amykyta3/nav-brick/README.md

# Nav-Brick

Have you ever wanted an altimeter for your car? Now you can.

This silly project implements an entirely over-engineered, GPS-compensated, pressure-based altimeter.
