amykyta3/nav-brick/hardware/BOM.ods

# | Reference | Value | Footprint | Qty | x3 | Have | Need | Buy | Digikey PN
1 | C2, C3, C4, C5, C6, C8, C9, C11, C13, C15, C16, C17, C18, C19, C20, C21, C22, C23, C53, C54 | 0.1u | Capacitor_SMD:C_0603_1608Metric | 20 | 60 | 39 | 21 | 30 | 399-C0603C104K3RAC7867CT-ND
2 | C7, C12 | 4.7u | Capacitor_SMD:C_0805_2012Metric | 2 | 6 | 19 | 0
3 | C10, C14, C50, C55 | 1u | Capacitor_SMD:C_0603_1608Metric | 4 | 12 | 71 | 0
4 | C51, C52 | 0.01u | Capacitor_SMD:C_0603_1608Metric | 2 | 6 | 74 | 0
5 | FB1 | FB | Capacitor_SMD:C_0603_1608Metric | 1 | 3 | 0 | 3 | 10 | 490-1037-1-ND
8 | J52 | USB4105-GF-A | Connector_USB:USB_C_Receptacle_GCT_USB4105-xx-A_16P_TopMnt_Horizontal | 1 | 3 | 0 | 3 | 5 | 2073-USB4105-GF-ACT-ND
14 | Q1, Q2, Q3, Q4 | DMP2004VK | 0-footprints:SOT-563 | 4 | 12 | 0 | 12 | 15 | DMP2004VKDICT-ND
15 | R2, R3, R4, R5, R6, R7, R8, R9 | 2.7k | Resistor_SMD:R_0402_1005Metric | 8 | 24 | 0 | 24 | 30 | 541-2.70KLCT-ND
16 | R50, R51 | 5.1k | Resistor_SMD:R_0402_1005Metric | 2 | 6 | 0 | 6 | 8 | 541-5.10KLCT-ND
17 | R52 | 1k | Resistor_SMD:R_0402_1005Metric | 1 | 3 | 75 | 0
18 | R53, R54 | 2.2k | Resistor_SMD:R_0402_1005Metric | 2 | 6 | 4 | 2 | 5 | 541-2.20KLCT-ND
19 | SW50, SW51 | PTS645SK50SMTR92 | Button_Switch_SMD:SW_Push_1P1T_NO_6x6mm_H9.5mm | 2 | 6 | 1 | 5 | 15 | CKN9087CT-ND
21 | U2 | MLX90393SLW-ABA-011 | Package_DFN_QFN:QFN-16-1EP_3x3mm_P0.5mm_EP1.7x1.7mm | 1 | 3 | 0 | 3 | 3 | MLX90393SLW-ABA-011-RECT-ND
22 | U3 | MM74HCT540MTCX | Package_SO:TSSOP-20_4.4x6.5mm_P0.65mm | 1 | 3 | 0 | 3 | 3 | MM74HCT540MTCXCT-ND
23 | U4 | MS5611-01BA | Package_LGA:LGA-8_3x5mm_P1.25mm | 1 | 3 | 0 | 3 | 3 | 223-1622-1-ND
24 | U5 | MM74HCT541MTCX | Package_SO:TSSOP-20_4.4x6.5mm_P0.65mm | 1 | 3 | 0 | 3 | 3 | MM74HCT541MTCXCT-ND
25 | U6 | AVR128DA32x-xRXB | Package_DFN_QFN:QFN-32-1EP_5x5mm_P0.5mm_EP3.1x3.1mm | 1 | 3 | 0 | 3 | 3 | 150-AVR128DA32T-I/RXBCT-ND
26 | U7 | FM25L16B | Package_SO:SOIC-8_3.9x4.9mm_P1.27mm | 1 | 3 | 0 | 3 | 3 | 448-FM25L16B-GTRCT-ND
27 | U8 | LP2981A-33DBV | Package_TO_SOT_SMD:SOT-23-5 | 1 | 3 | 4 | 0
28 | U9, U10, U11, U12, U13, U14, U15, U16 | TLC59284 | Package_SO:SSOP-24_3.9x8.7mm_P0.635mm | 8 | 24 | 0 | 24 | 26 | 296-39245-1-ND
29 | U50 | CY7C65223D | Package_DFN_QFN:QFN-32-1EP_5x5mm_P0.5mm_EP3.6x3.6mm | 1 | 3 | 0 | 3 | 3 | 448-CY7C65223D-32LTXI-ND
30 | U51 | SAM-M10Q | RF_GPS:ublox_SAM-M8Q | 1 | 3 | 0 | 3 | 3 | 672-SAM-M10Q-00BCT-ND
31 | U52 | LTR-329ALS-01 | 0-footprints:LTR-329ALS-01 | 1 | 3 | 0 | 3 | 3 | 160-2160-1-ND
32 | U53, U54, U55, U56 | P3786E | 0-footprints:LTP-378x | 4 | 12 | 0 | 12 | 12 | 160-1011-ND
 |  |  | RA Pin header breakaway
