amykyta3/nav-brick/hardware/assembly-list.ods

Paste & Reflow First
1 | U51 | SAM-M10Q
1 | U52 | LTR-329ALS-01
1 | U50 | CY7C65223D
 | (flip over)
1 | U3 | MM74HCT540MTCX
1 | U5 | MM74HCT541MTCX
1 | U6 | AVR128DA32x-xRXB
1 | U2 | MLX90393SLW-ABA-011
1 | U4 | MS5611-01BA
1 | U8 | LP2981A-33DBV
8 | U9, U10, U11, U12, U13, U14, U15, U16 | TLC59284
4 | Q1, Q2, Q3, Q4 | DMP2004VK
Hand Solder Passives
20 | C2, C3, C4, C5, C6, C8, C9, C11, C13, C15, C16, C17, C18, C19, C20, C21, C22, C23, C53, C54 | 0.1u
2 | C7, C12 | 4.7u
4 | C10, C14, C50, C55 | 1u
2 | C51, C52 | 0.01u
1 | FB1 | FB
8 | R2, R3, R4, R5, R6, R7, R8, R9 | 2.7k
2 | R50, R51 | 5.1k
1 | R52 | 1k
2 | R53, R54 | 2.2k
Hand Solder IC
1 | U7 | FM25L16B
Big & Bulky. Do last
4 | U53, U54, U55, U56 | P3786E
2 | SW50, SW51 | PTS645SK50SMTR92
1 | J52 | USB4105-GF-A
