amykyta3/nav-brick/hardware/navbrick.pdf

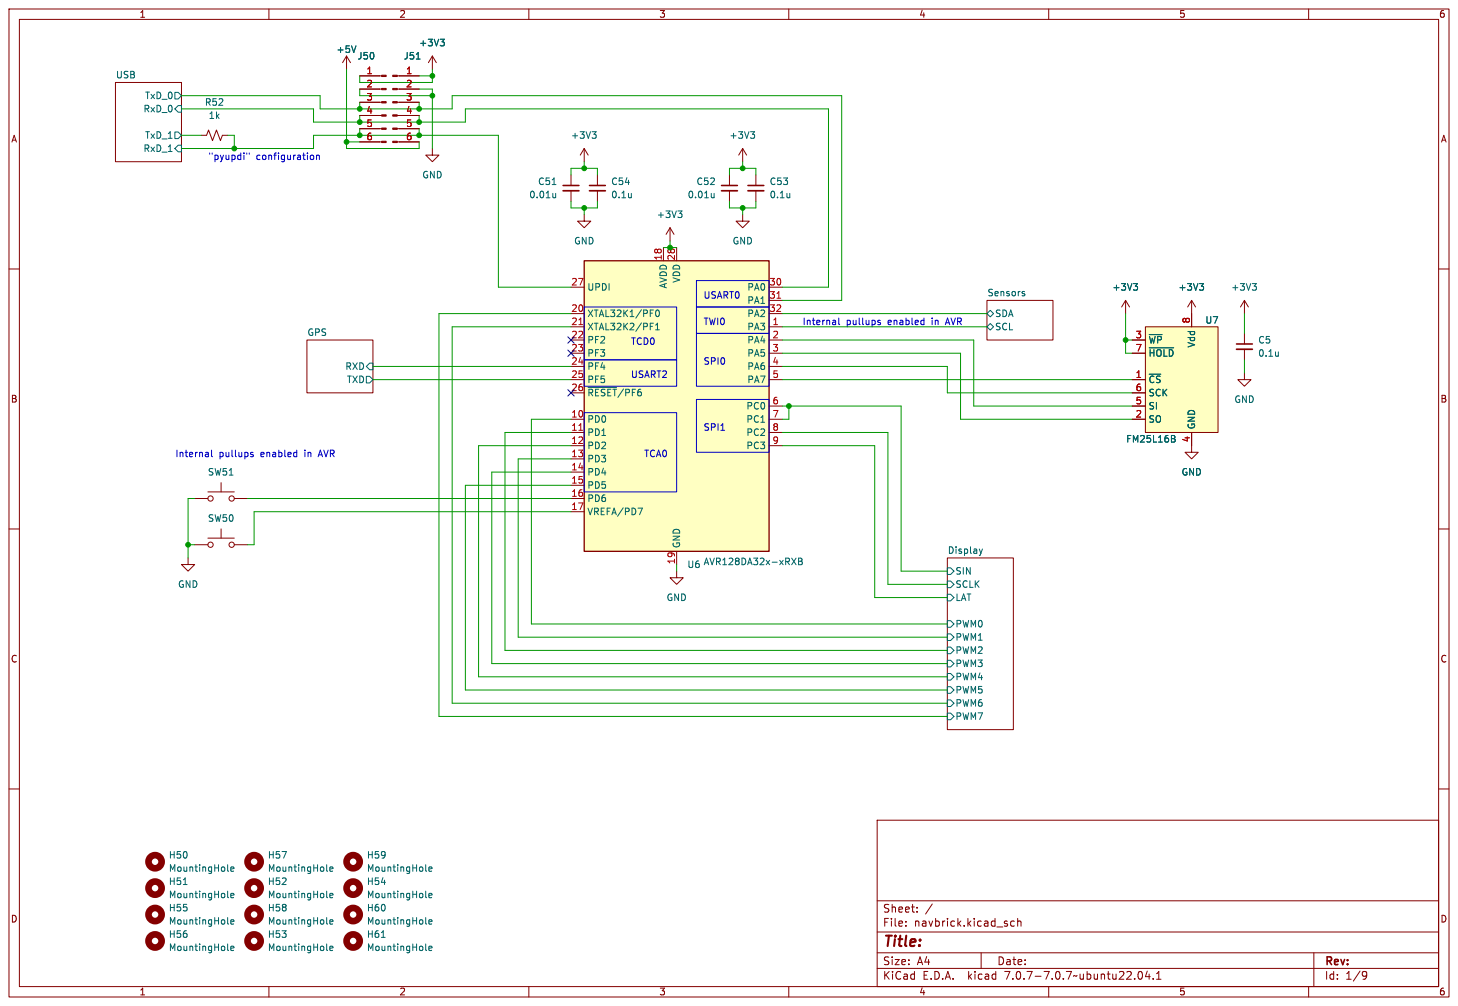
[picture p1: page 1]

4 SI 5 SCK 6 ~{HOLD} 7 Vdd

Id: 1/9 Title: File: navbrick.kicad_sch Sheet: /

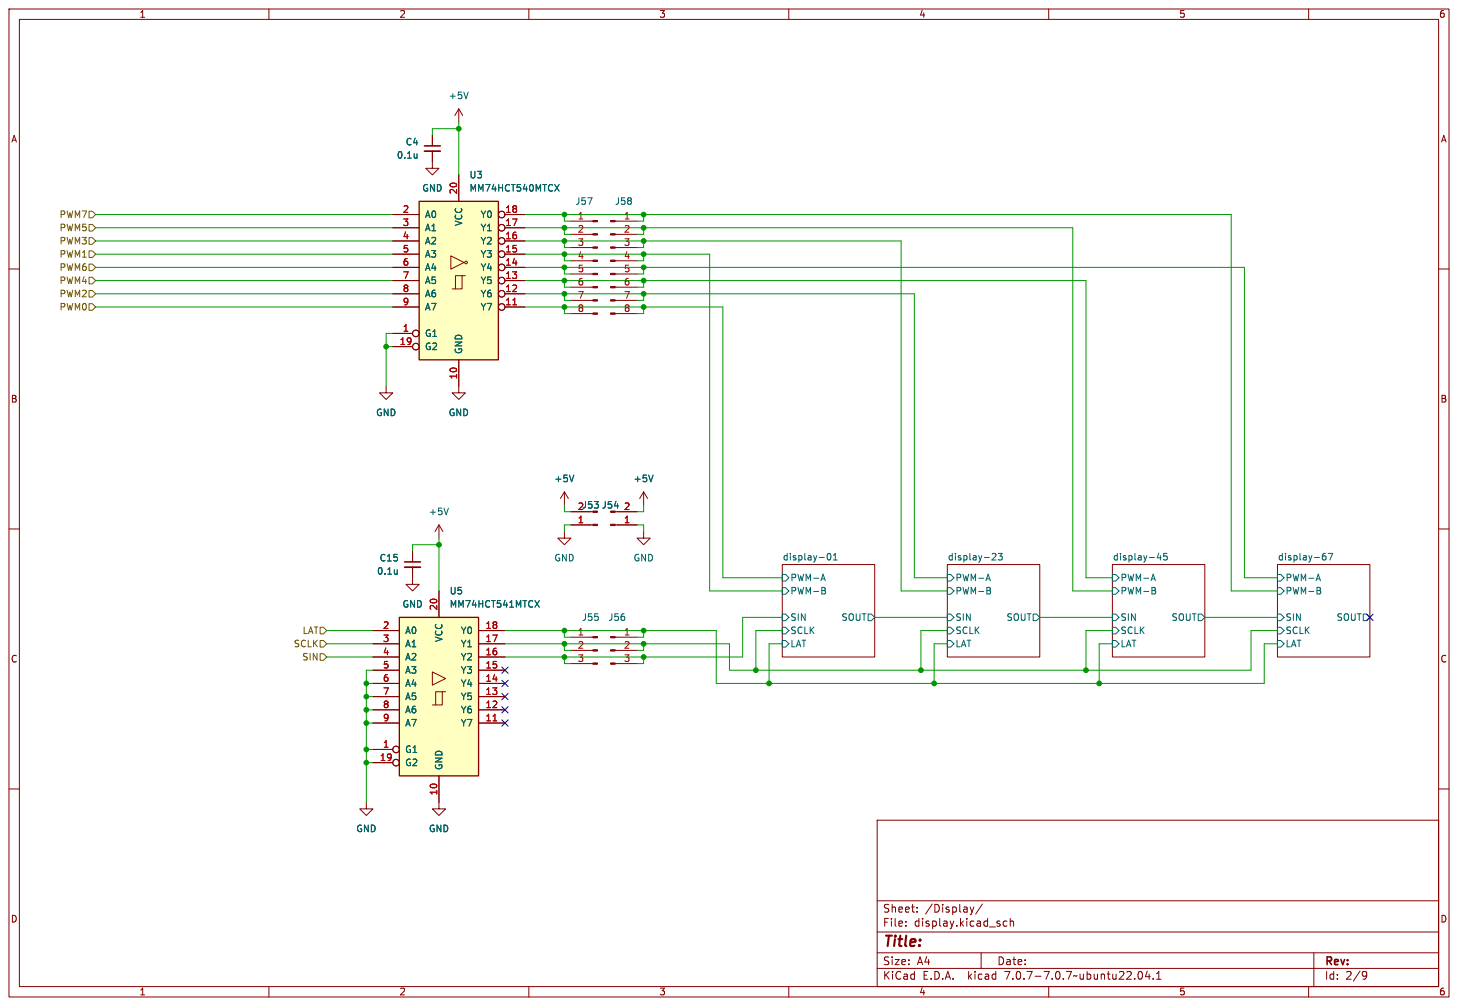
[picture p2: page 2]

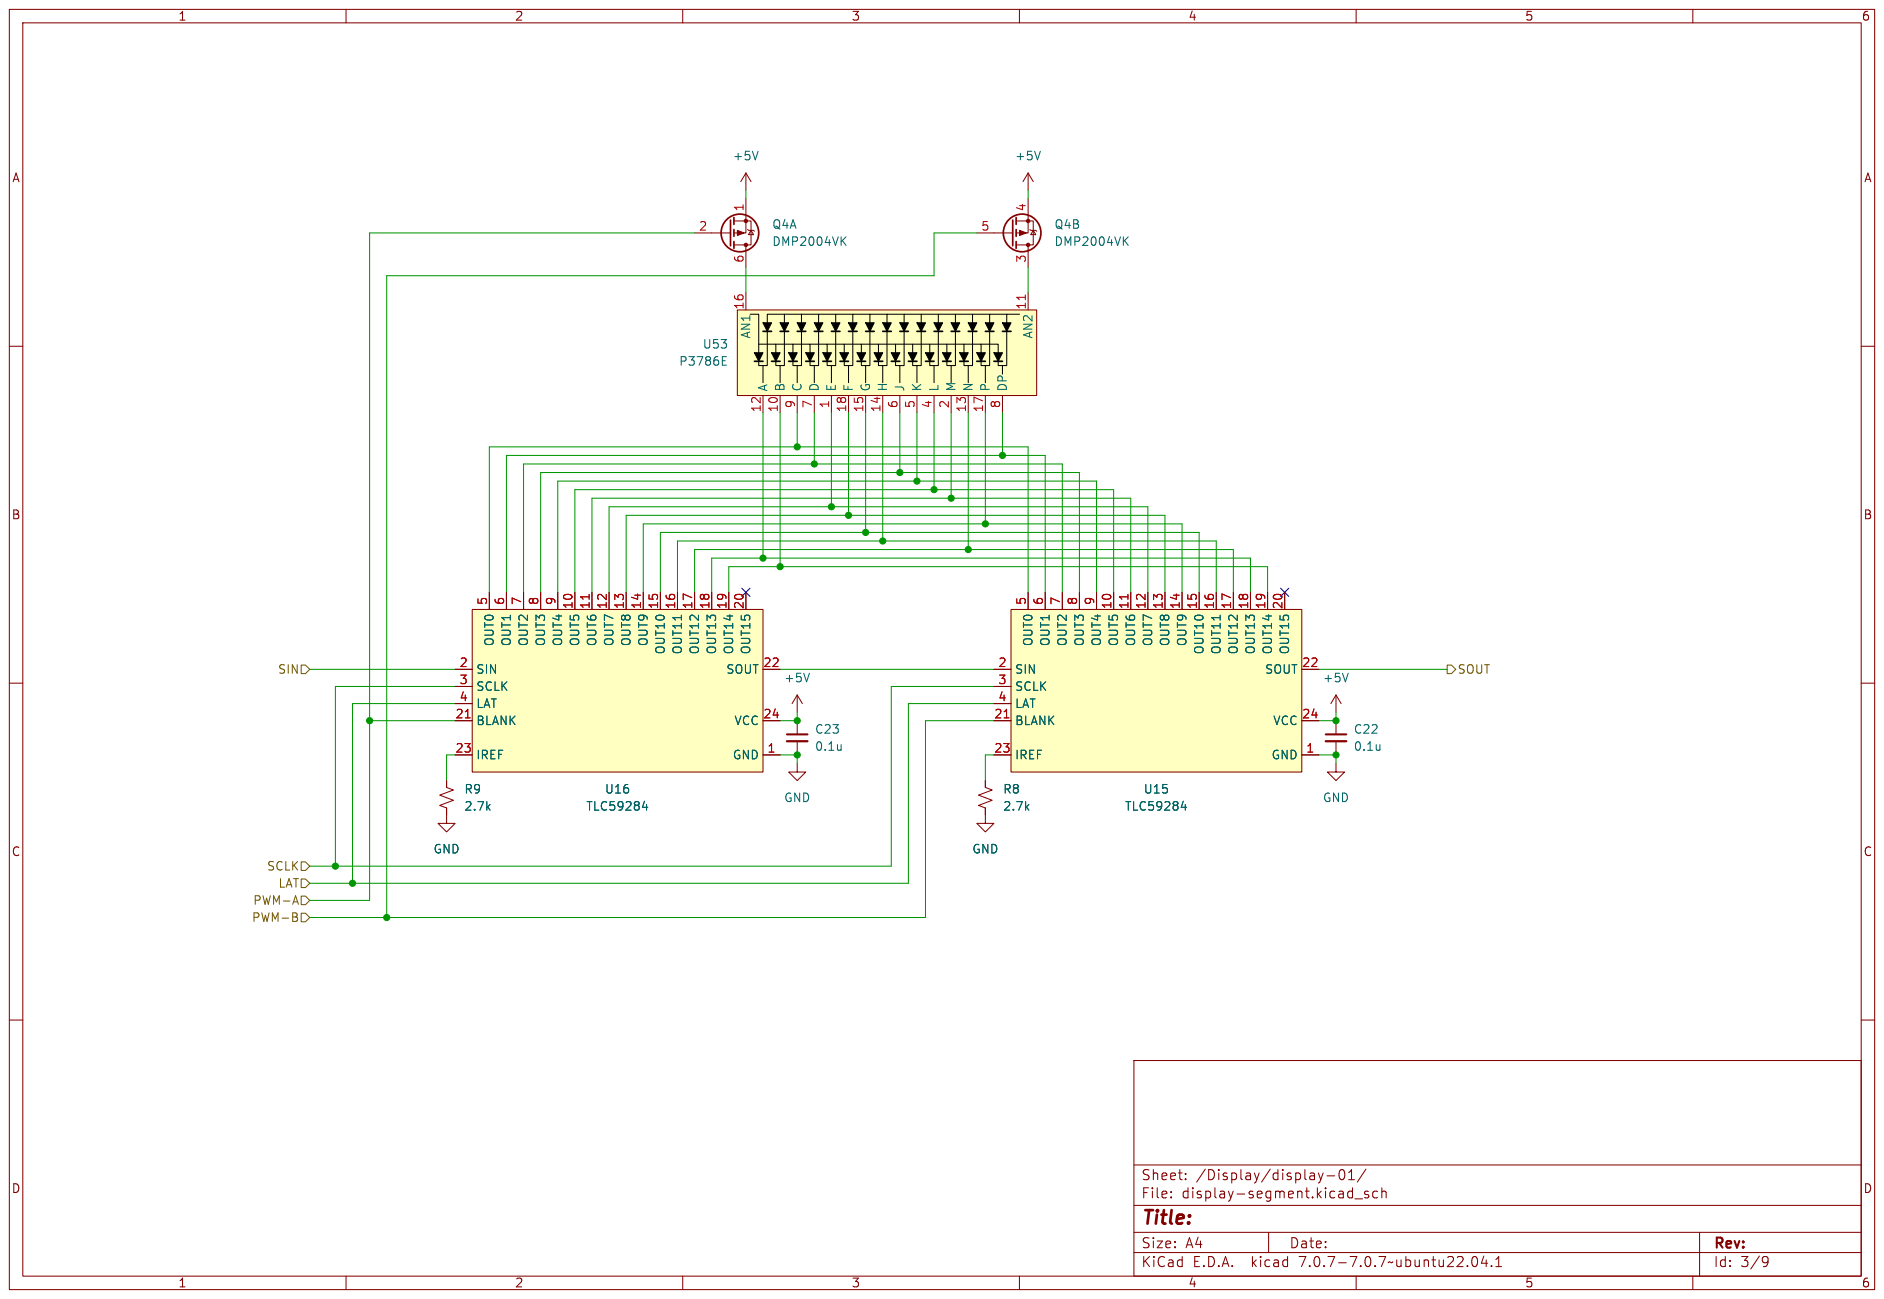
[picture p3: page 3]

Id: 3/9 Title: File: display-segment.kicad_sch Sheet: /Display/display-01/

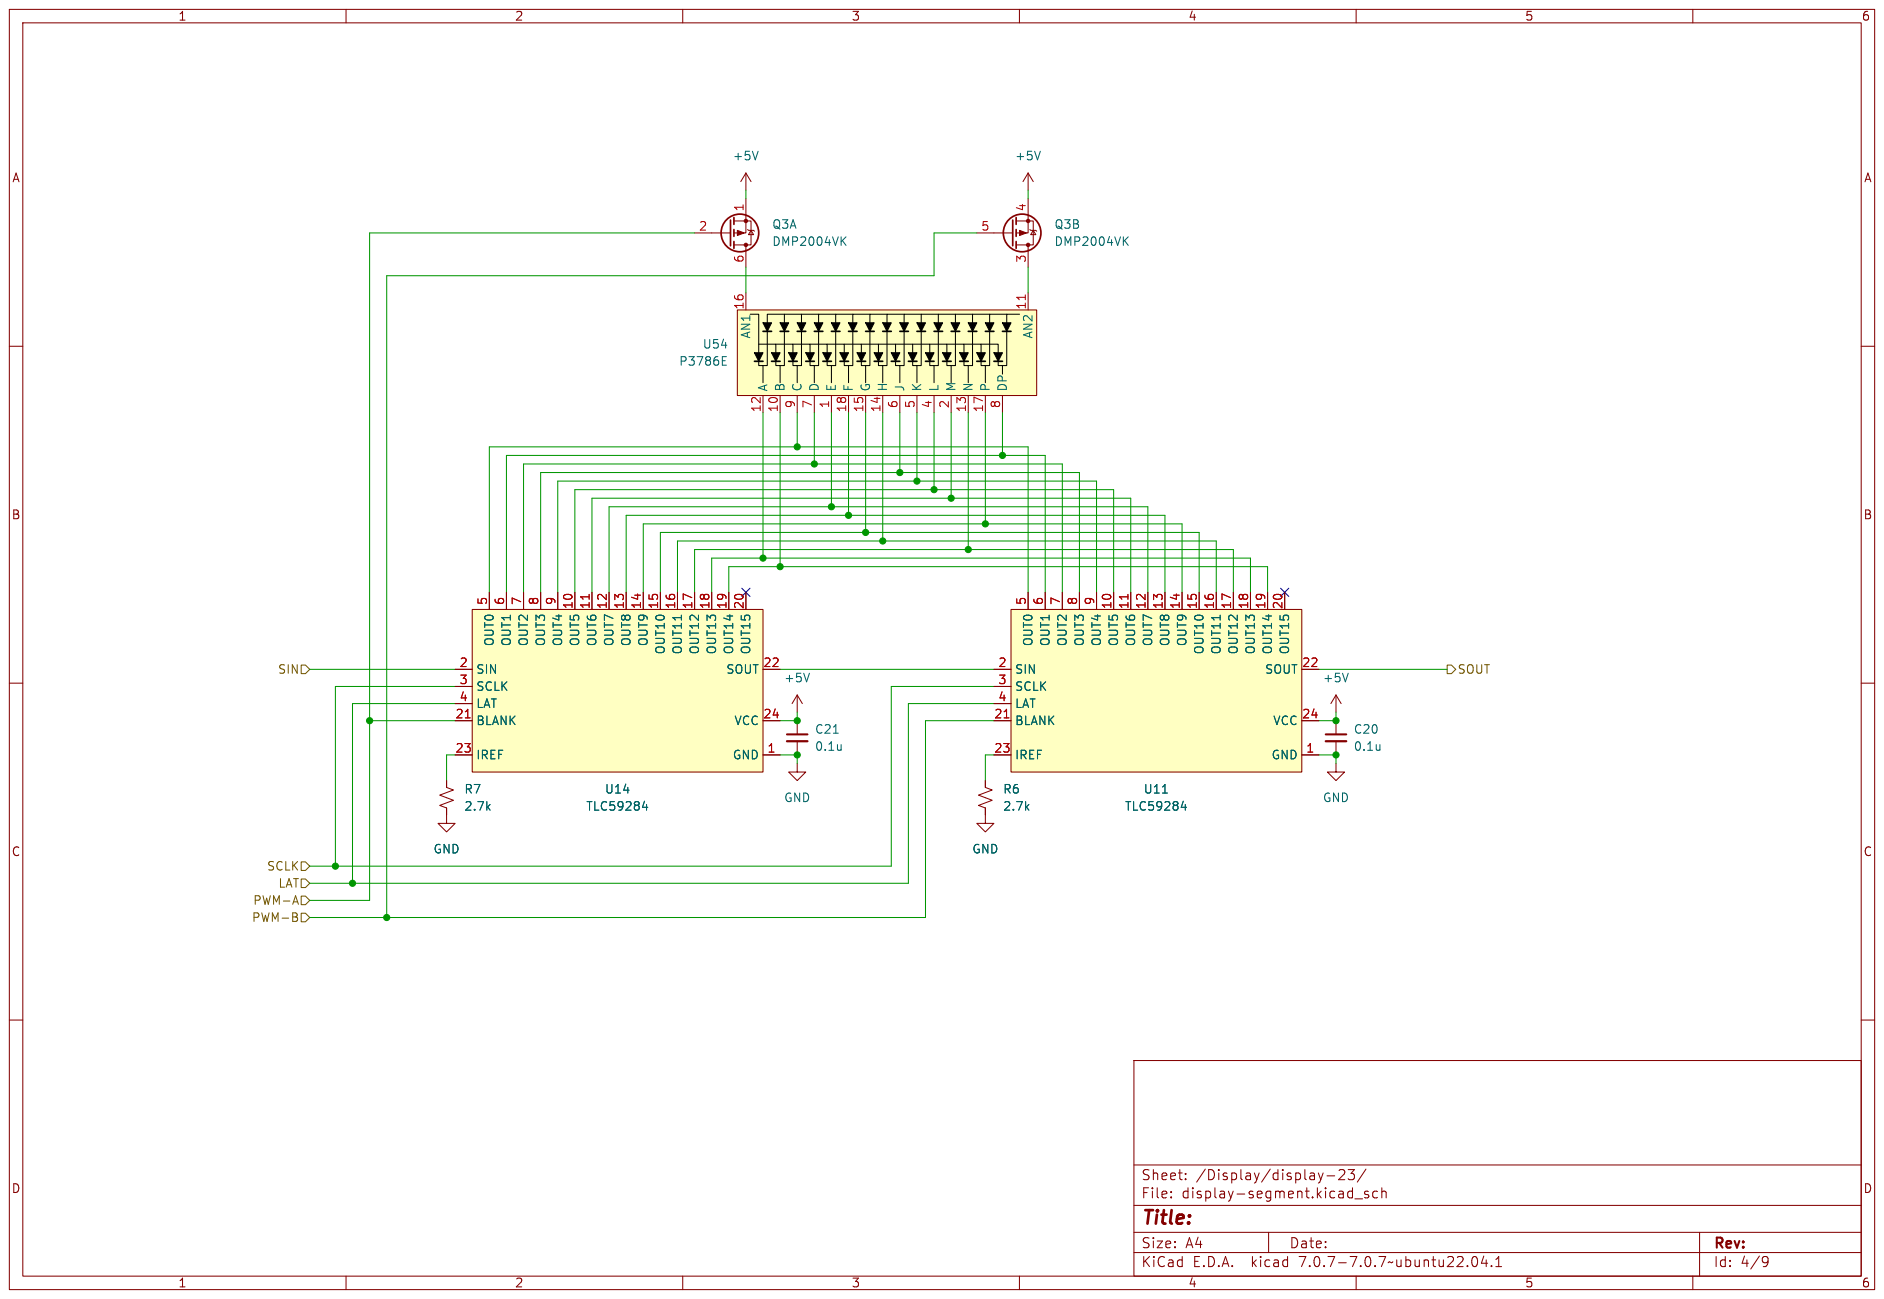
[picture p4: page 4]

Id: 4/9 Title: File: display-segment.kicad_sch Sheet: /Display/display-23/

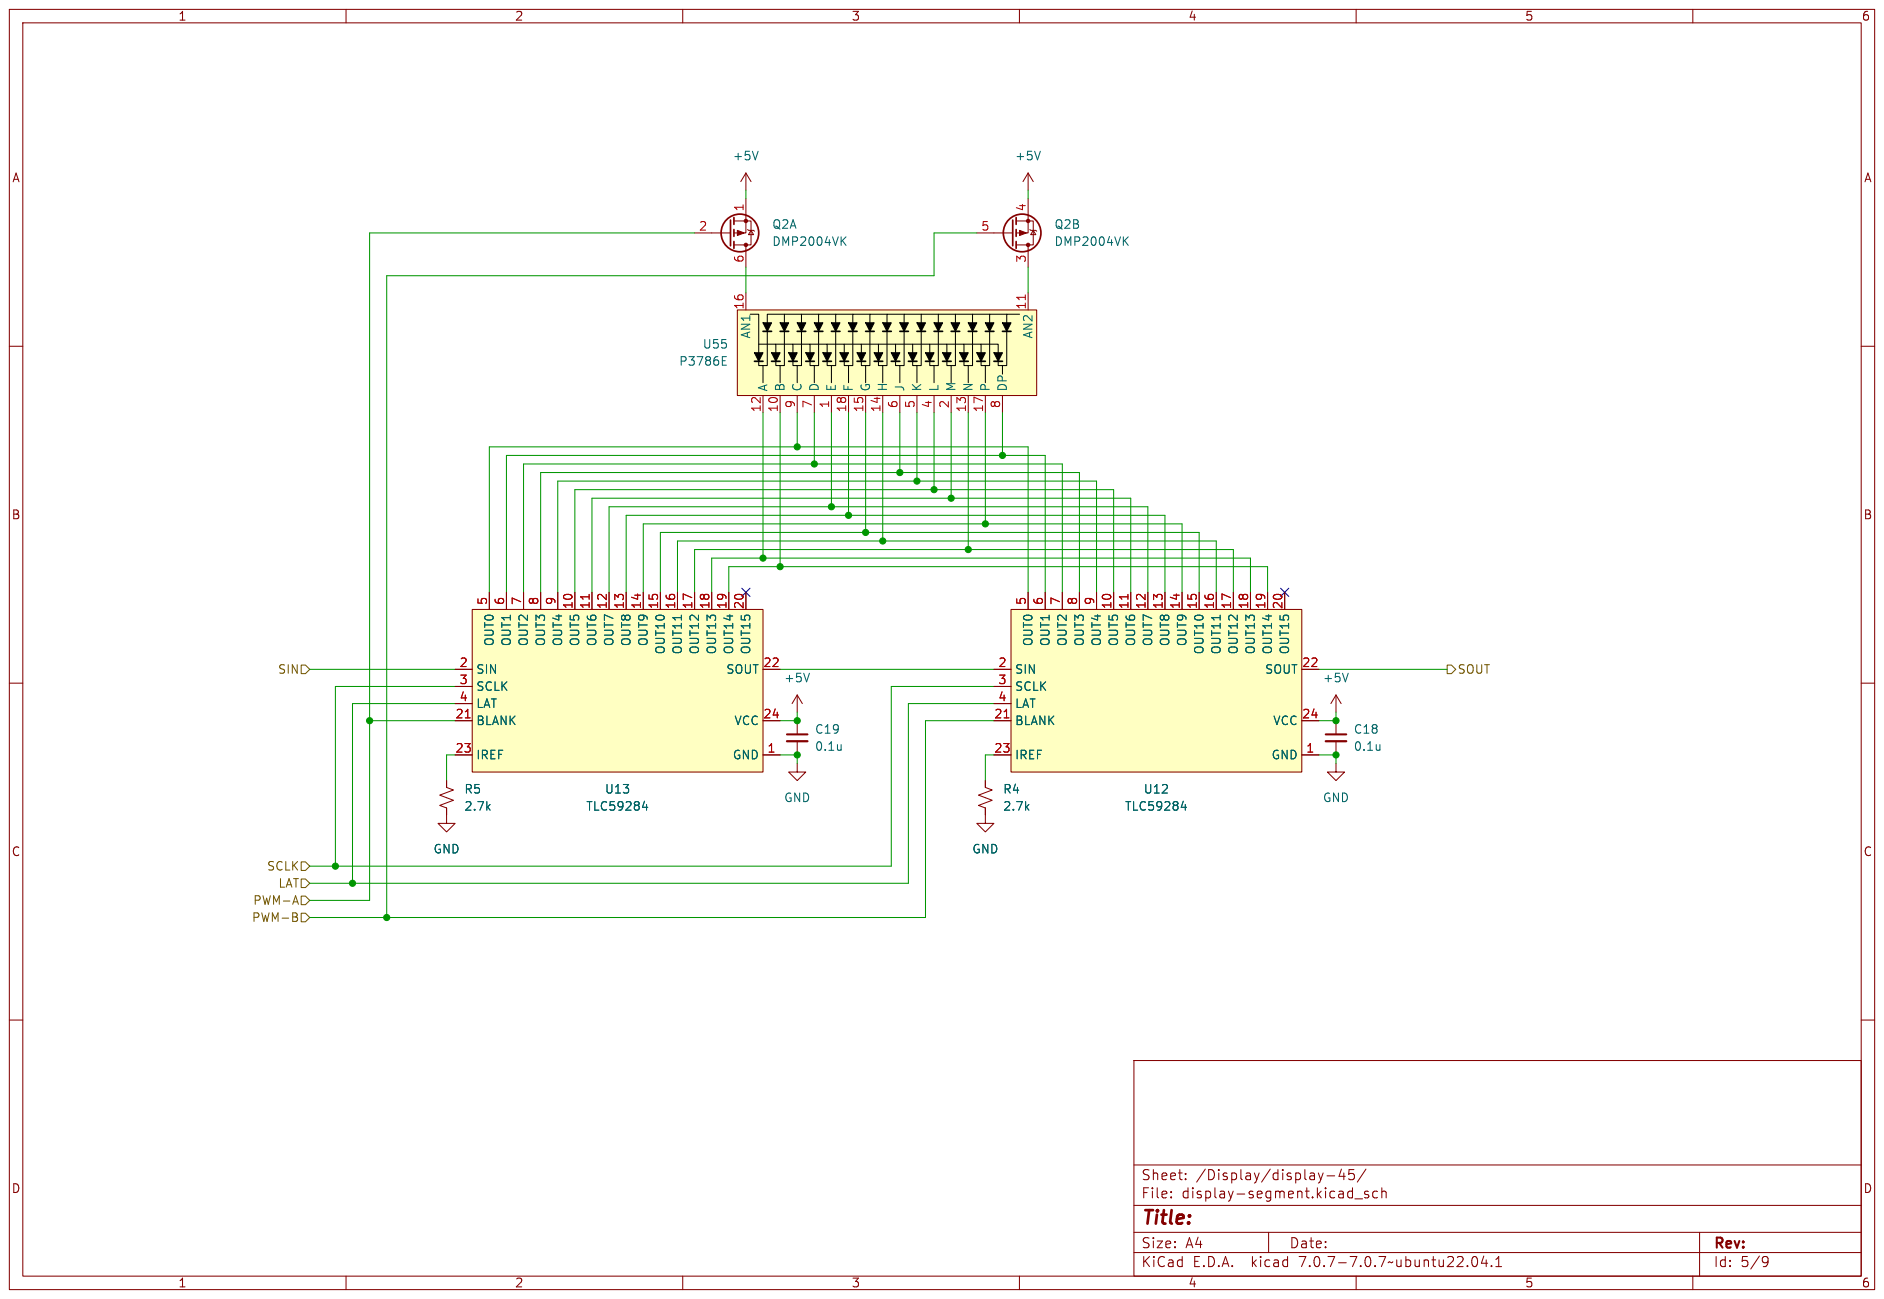
[picture p5: page 5]

Id: 5/9 Title: File: display-segment.kicad_sch Sheet: /Display/display-45/

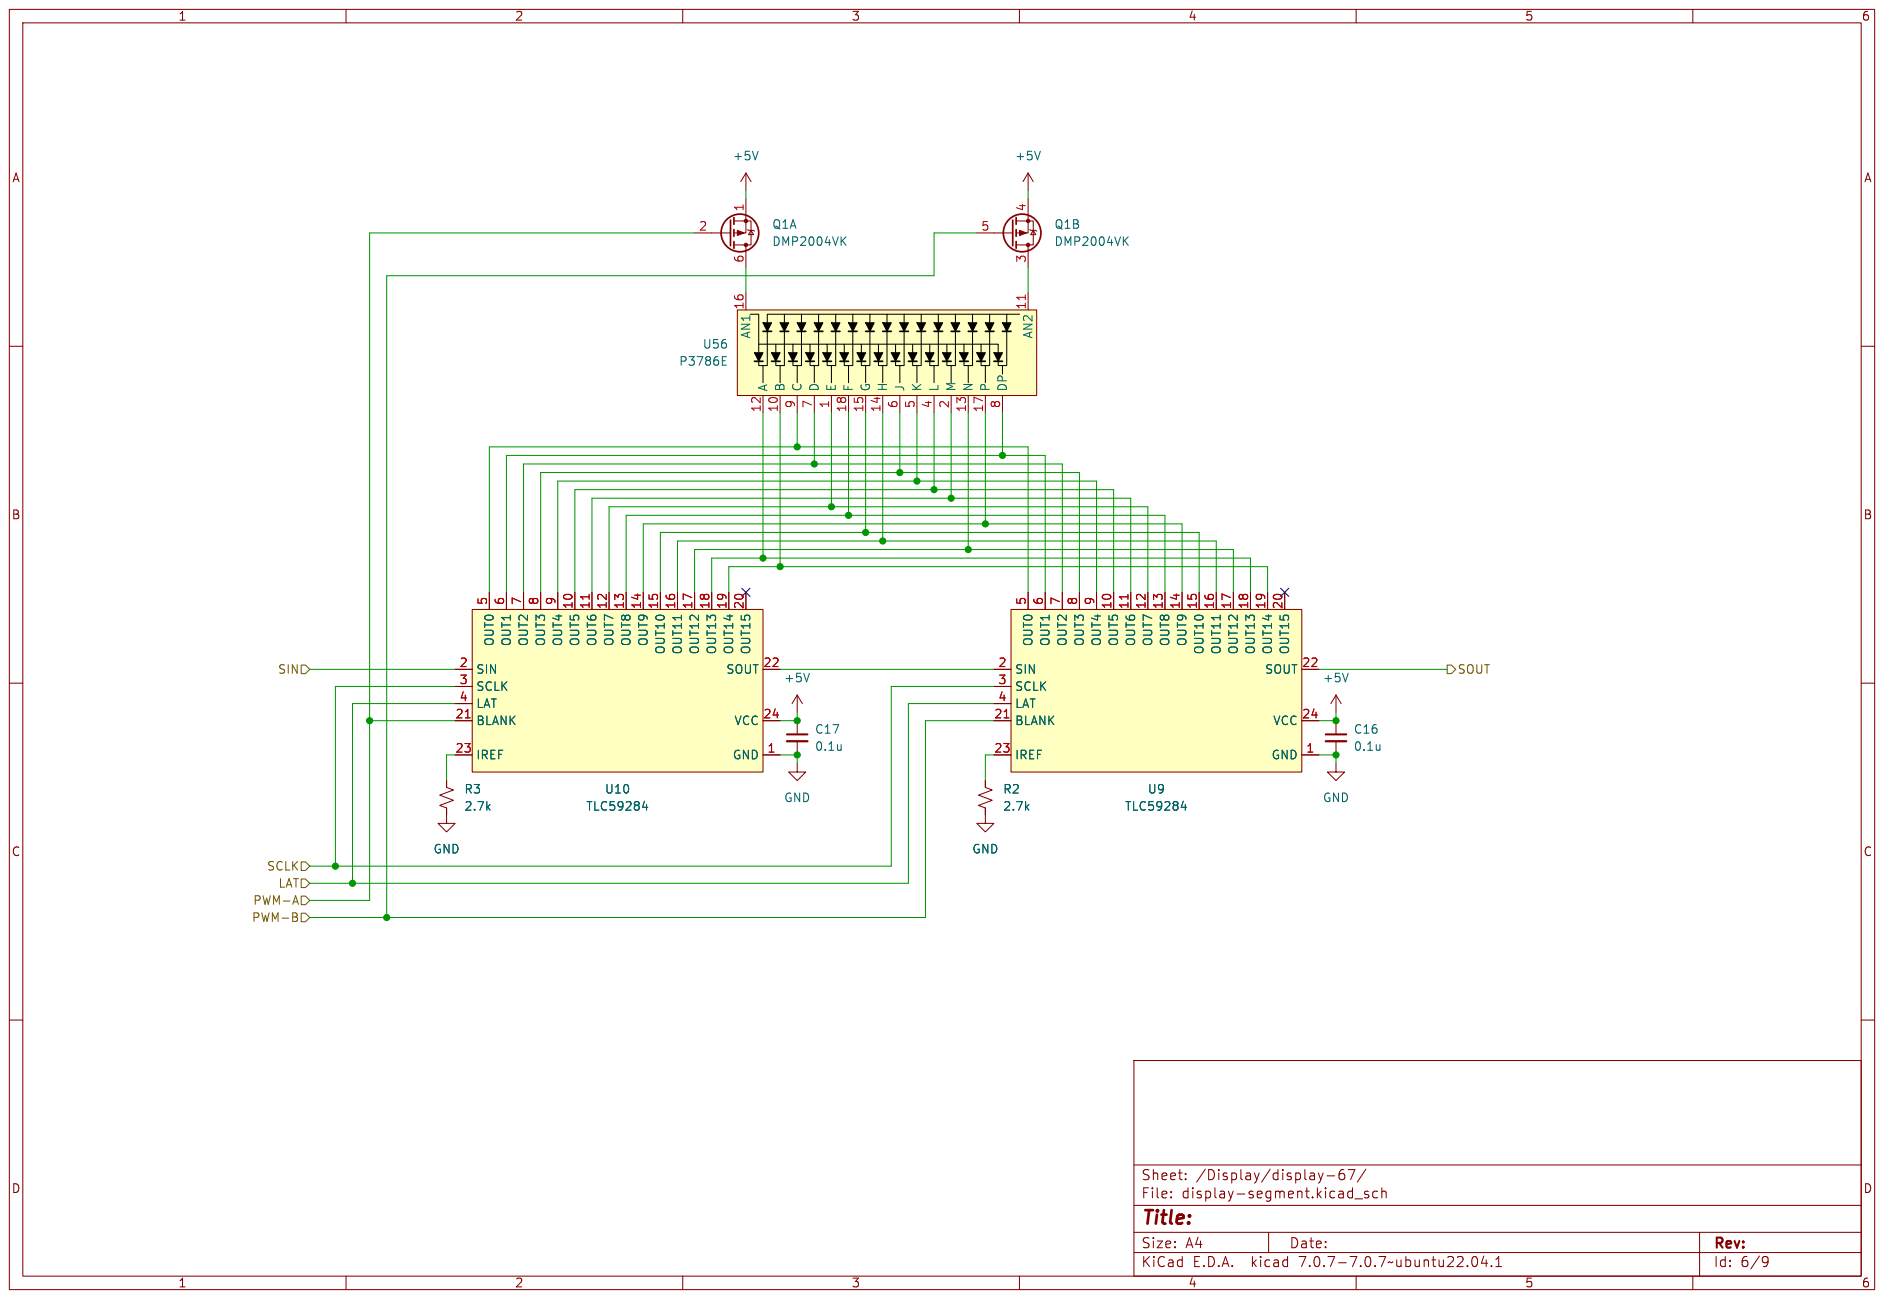
[picture p6: page 6]

Id: 6/9 Title: File: display-segment.kicad_sch Sheet: /Display/display-67/

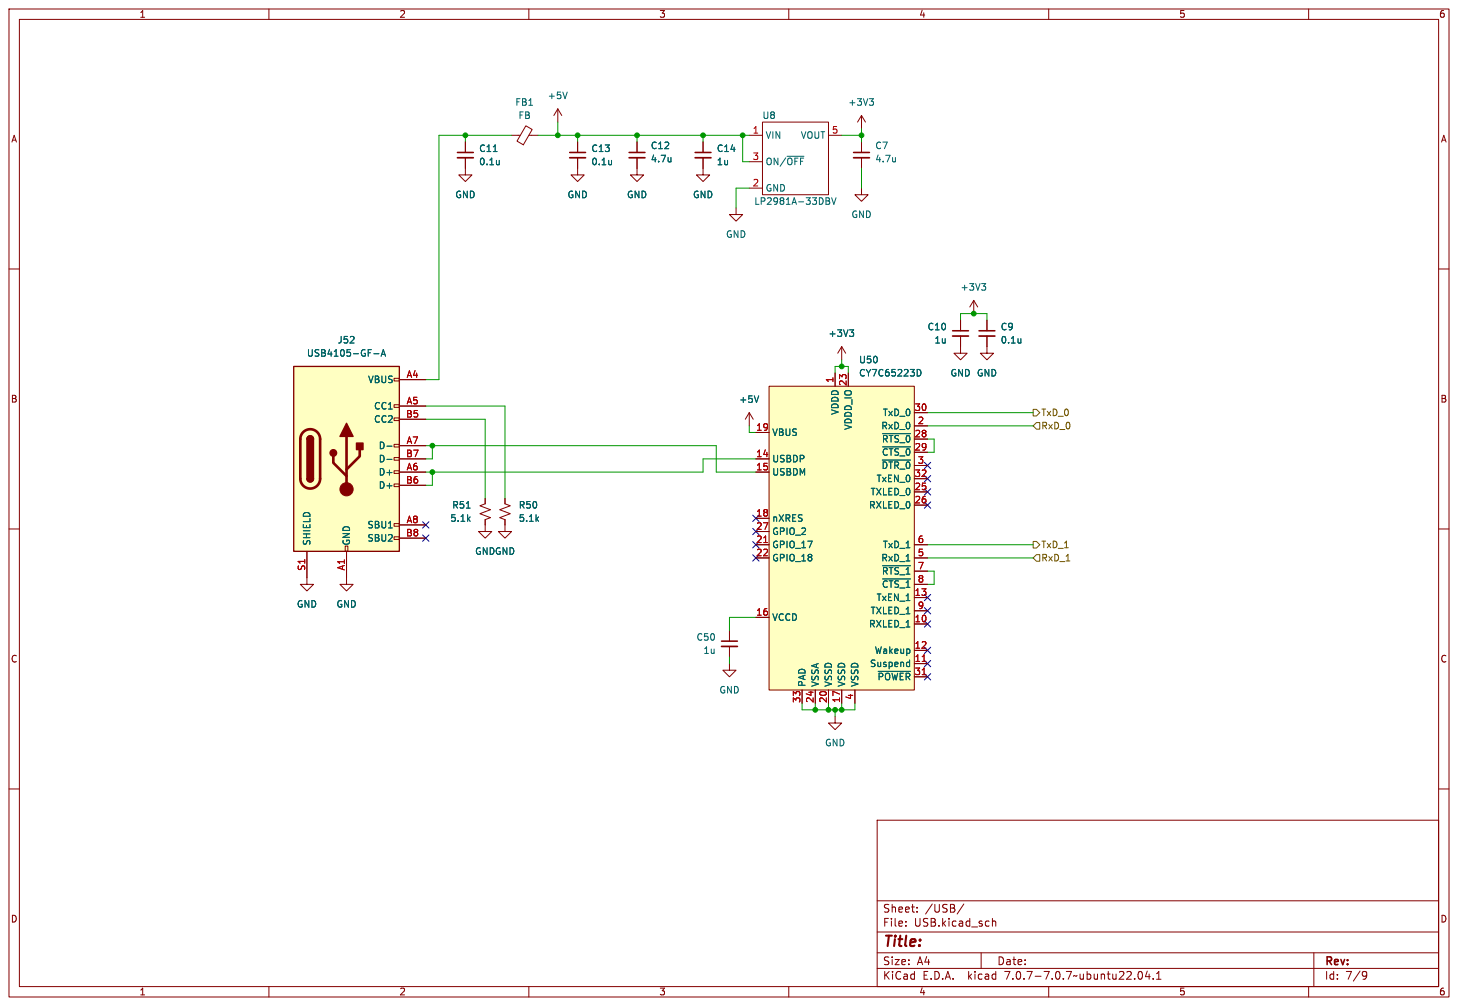
[picture p7: page 7]

Id: 7/9 Title: File: USB.kicad_sch Sheet: /USB/

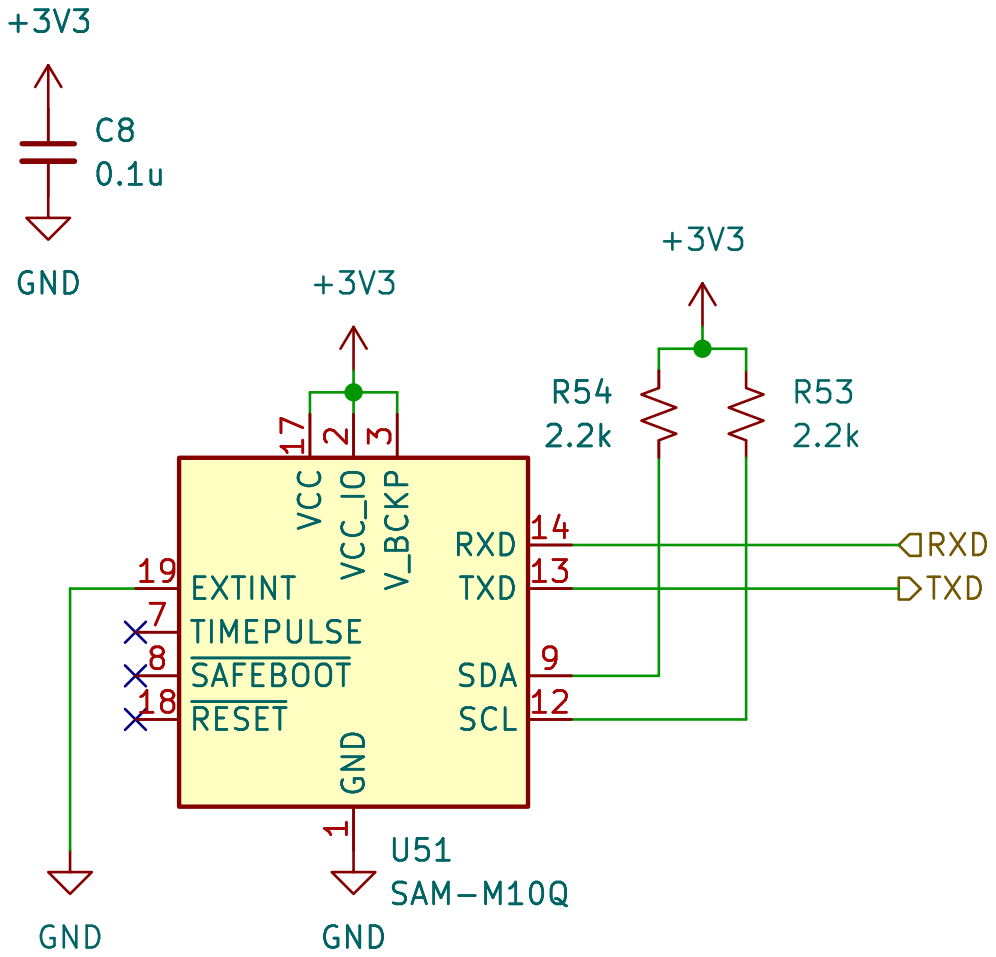
[picture p8: page 8]

3 TIMEPULSE 7 ~{SAFEBOOT} 8 SDA 9 U51 SAM-M10Q

3 TIMEPULSE 7 ~{SAFEBOOT} 8 SDA 9 GND

1 SCL 12 TXD 13 RXD VCC 14 17

Id: 8/9 Title: File: GPS.kicad_sch Sheet: /GPS/

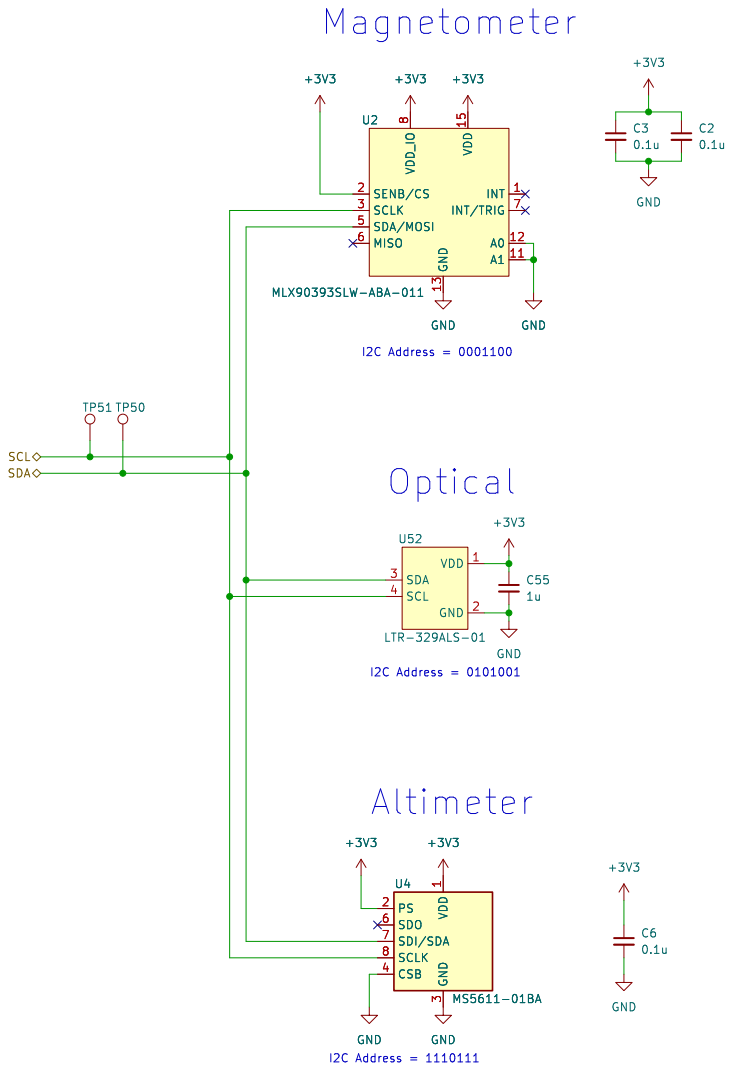
[picture p9: page 9]

Id: 9/9 Title: File: sensors.kicad_sch Sheet: /Sensors/
