amykyta3/nav-brick/firmware/cli_commands.h

#ifndef CLI_COMMANDS_H
#define CLI_COMMANDS_H

#include "utils/cli.h"
#include <stdint.h>

// If set to 1, command parsing recognizes multi-word arguments in quotes
#define PARSE_QUOTED_ARGS   1

// If set to 1, performs command lookup using a binary search instead of linear.
#define USE_BINARY_SEARCH   0

// maximum length of a command input line
#define CLI_STRBUF_SIZE    64

// Maximum number of arguments in a command (including command).
#define CLI_MAX_ARGC    5

// Table of commands: {"command_word" , function }
// If using binary search, command words MUST be in alphabetical (ascii) order (A-Z then a-z)
#define CMDTABLE    {"args"  , cmd_ArgList  },\
                    {"db"    , cmd_SetLightness},\
                    {"dp"    , cmd_SetLightness},\
                    {"d"     , cmd_Debug},\
                    {"s"     , cmd_DumpSlate}


// Custom command function prototypes:
int cmd_ArgList(uint8_t argc, char *argv[]);
int cmd_SetLightness(uint8_t argc, char *argv[]);
int cmd_DumpSlate(uint8_t argc, char *argv[]);
int cmd_Debug(uint8_t argc, char *argv[]);

#endif
