amykyta3/nav-brick/test/rtc/mock_avr/avr_includes/avr/io.h

#ifndef AVR_IO_H
#define AVR_IO_H

#include <stdint.h>

typedef volatile uint8_t register8_t;
typedef volatile uint16_t register16_t;
typedef volatile uint32_t register32_t;

#define _WORDREGISTER(regname)   \
    union { \
        register16_t regname; \
        struct { \
            register8_t regname ## L; \
            register8_t regname ## H; \
        }; \
    }

/*
--------------------------------------------------------------------------
RTC - Real-Time Counter
--------------------------------------------------------------------------
*/

/* Real-Time Counter */
typedef struct RTC_struct
{
    register8_t CTRLA;  /* Control A */
    register8_t STATUS;  /* Status */
    register8_t INTCTRL;  /* Interrupt Control */
    register8_t INTFLAGS;  /* Interrupt Flags */
    register8_t TEMP;  /* Temporary */
    register8_t DBGCTRL;  /* Debug control */
    register8_t CALIB;  /* Calibration */
    register8_t CLKSEL;  /* Clock Select */
    _WORDREGISTER(CNT);  /* Counter */
    _WORDREGISTER(PER);  /* Period */
    _WORDREGISTER(CMP);  /* Compare */
    register8_t reserved_1[2];
    register8_t PITCTRLA;  /* PIT Control A */
    register8_t PITSTATUS;  /* PIT Status */
    register8_t PITINTCTRL;  /* PIT Interrupt Control */
    register8_t PITINTFLAGS;  /* PIT Interrupt Flags */
    register8_t reserved_2[1];
    register8_t PITDBGCTRL;  /* PIT Debug control */
    register8_t reserved_3[10];
} RTC_t;

/* Clock Select */
typedef enum RTC_CLKSEL_enum
{
    RTC_CLKSEL_OSC32K_gc = (0x00<<0),  /* 32.768 kHz from OSC32K */
    RTC_CLKSEL_OSC1K_gc = (0x01<<0),  /* 1.024 kHz from OSC32K */
    RTC_CLKSEL_XOSC32K_gc = (0x02<<0),  /* 32.768 kHz from XOSC32K */
    RTC_CLKSEL_EXTCLK_gc = (0x03<<0)  /* External Clock */
} RTC_CLKSEL_t;

/* Period select */
typedef enum RTC_PERIOD_enum
{
    RTC_PERIOD_OFF_gc = (0x00<<3),  /* Off */
    RTC_PERIOD_CYC4_gc = (0x01<<3),  /* RTC Clock Cycles 4 */
    RTC_PERIOD_CYC8_gc = (0x02<<3),  /* RTC Clock Cycles 8 */
    RTC_PERIOD_CYC16_gc = (0x03<<3),  /* RTC Clock Cycles 16 */
    RTC_PERIOD_CYC32_gc = (0x04<<3),  /* RTC Clock Cycles 32 */
    RTC_PERIOD_CYC64_gc = (0x05<<3),  /* RTC Clock Cycles 64 */
    RTC_PERIOD_CYC128_gc = (0x06<<3),  /* RTC Clock Cycles 128 */
    RTC_PERIOD_CYC256_gc = (0x07<<3),  /* RTC Clock Cycles 256 */
    RTC_PERIOD_CYC512_gc = (0x08<<3),  /* RTC Clock Cycles 512 */
    RTC_PERIOD_CYC1024_gc = (0x09<<3),  /* RTC Clock Cycles 1024 */
    RTC_PERIOD_CYC2048_gc = (0x0A<<3),  /* RTC Clock Cycles 2048 */
    RTC_PERIOD_CYC4096_gc = (0x0B<<3),  /* RTC Clock Cycles 4096 */
    RTC_PERIOD_CYC8192_gc = (0x0C<<3),  /* RTC Clock Cycles 8192 */
    RTC_PERIOD_CYC16384_gc = (0x0D<<3),  /* RTC Clock Cycles 16384 */
    RTC_PERIOD_CYC32768_gc = (0x0E<<3)  /* RTC Clock Cycles 32768 */
} RTC_PERIOD_t;

/* Prescaling Factor select */
typedef enum RTC_PRESCALER_enum
{
    RTC_PRESCALER_DIV1_gc = (0x00<<3),  /* RTC Clock / 1 */
    RTC_PRESCALER_DIV2_gc = (0x01<<3),  /* RTC Clock / 2 */
    RTC_PRESCALER_DIV4_gc = (0x02<<3),  /* RTC Clock / 4 */
    RTC_PRESCALER_DIV8_gc = (0x03<<3),  /* RTC Clock / 8 */
    RTC_PRESCALER_DIV16_gc = (0x04<<3),  /* RTC Clock / 16 */
    RTC_PRESCALER_DIV32_gc = (0x05<<3),  /* RTC Clock / 32 */
    RTC_PRESCALER_DIV64_gc = (0x06<<3),  /* RTC Clock / 64 */
    RTC_PRESCALER_DIV128_gc = (0x07<<3),  /* RTC Clock / 128 */
    RTC_PRESCALER_DIV256_gc = (0x08<<3),  /* RTC Clock / 256 */
    RTC_PRESCALER_DIV512_gc = (0x09<<3),  /* RTC Clock / 512 */
    RTC_PRESCALER_DIV1024_gc = (0x0A<<3),  /* RTC Clock / 1024 */
    RTC_PRESCALER_DIV2048_gc = (0x0B<<3),  /* RTC Clock / 2048 */
    RTC_PRESCALER_DIV4096_gc = (0x0C<<3),  /* RTC Clock / 4096 */
    RTC_PRESCALER_DIV8192_gc = (0x0D<<3),  /* RTC Clock / 8192 */
    RTC_PRESCALER_DIV16384_gc = (0x0E<<3),  /* RTC Clock / 16384 */
    RTC_PRESCALER_DIV32768_gc = (0x0F<<3)  /* RTC Clock / 32768 */
} RTC_PRESCALER_t;

/* RTC - Real-Time Counter */
/* RTC.CTRLA  bit masks and bit positions */
#define RTC_RTCEN_bm  0x01  /* Enable bit mask. */
#define RTC_RTCEN_bp  0  /* Enable bit position. */
#define RTC_CORREN_bm  0x04  /* Correction enable bit mask. */
#define RTC_CORREN_bp  2  /* Correction enable bit position. */
#define RTC_PRESCALER_gm  0x78  /* Prescaling Factor group mask. */
#define RTC_PRESCALER_gp  3  /* Prescaling Factor group position. */
#define RTC_PRESCALER_0_bm  (1<<3)  /* Prescaling Factor bit 0 mask. */
#define RTC_PRESCALER_0_bp  3  /* Prescaling Factor bit 0 position. */
#define RTC_PRESCALER_1_bm  (1<<4)  /* Prescaling Factor bit 1 mask. */
#define RTC_PRESCALER_1_bp  4  /* Prescaling Factor bit 1 position. */
#define RTC_PRESCALER_2_bm  (1<<5)  /* Prescaling Factor bit 2 mask. */
#define RTC_PRESCALER_2_bp  5  /* Prescaling Factor bit 2 position. */
#define RTC_PRESCALER_3_bm  (1<<6)  /* Prescaling Factor bit 3 mask. */
#define RTC_PRESCALER_3_bp  6  /* Prescaling Factor bit 3 position. */
#define RTC_RUNSTDBY_bm  0x80  /* Run In Standby bit mask. */
#define RTC_RUNSTDBY_bp  7  /* Run In Standby bit position. */

/* RTC.STATUS  bit masks and bit positions */
#define RTC_CTRLABUSY_bm  0x01  /* CTRLA Synchronization Busy Flag bit mask. */
#define RTC_CTRLABUSY_bp  0  /* CTRLA Synchronization Busy Flag bit position. */
#define RTC_CNTBUSY_bm  0x02  /* Count Synchronization Busy Flag bit mask. */
#define RTC_CNTBUSY_bp  1  /* Count Synchronization Busy Flag bit position. */
#define RTC_PERBUSY_bm  0x04  /* Period Synchronization Busy Flag bit mask. */
#define RTC_PERBUSY_bp  2  /* Period Synchronization Busy Flag bit position. */
#define RTC_CMPBUSY_bm  0x08  /* Comparator Synchronization Busy Flag bit mask. */
#define RTC_CMPBUSY_bp  3  /* Comparator Synchronization Busy Flag bit position. */

/* RTC.INTCTRL  bit masks and bit positions */
#define RTC_OVF_bm  0x01  /* Overflow Interrupt enable bit mask. */
#define RTC_OVF_bp  0  /* Overflow Interrupt enable bit position. */
#define RTC_CMP_bm  0x02  /* Compare Match Interrupt enable bit mask. */
#define RTC_CMP_bp  1  /* Compare Match Interrupt enable bit position. */

/* RTC.INTFLAGS  bit masks and bit positions */
/* RTC_OVF  is already defined. */
/* RTC_CMP  is already defined. */

/* RTC.DBGCTRL  bit masks and bit positions */
#define RTC_DBGRUN_bm  0x01  /* Run in debug bit mask. */
#define RTC_DBGRUN_bp  0  /* Run in debug bit position. */

/* RTC.CALIB  bit masks and bit positions */
#define RTC_ERROR_gm  0x7F  /* Error Correction Value group mask. */
#define RTC_ERROR_gp  0  /* Error Correction Value group position. */
#define RTC_ERROR_0_bm  (1<<0)  /* Error Correction Value bit 0 mask. */
#define RTC_ERROR_0_bp  0  /* Error Correction Value bit 0 position. */
#define RTC_ERROR_1_bm  (1<<1)  /* Error Correction Value bit 1 mask. */
#define RTC_ERROR_1_bp  1  /* Error Correction Value bit 1 position. */
#define RTC_ERROR_2_bm  (1<<2)  /* Error Correction Value bit 2 mask. */
#define RTC_ERROR_2_bp  2  /* Error Correction Value bit 2 position. */
#define RTC_ERROR_3_bm  (1<<3)  /* Error Correction Value bit 3 mask. */
#define RTC_ERROR_3_bp  3  /* Error Correction Value bit 3 position. */
#define RTC_ERROR_4_bm  (1<<4)  /* Error Correction Value bit 4 mask. */
#define RTC_ERROR_4_bp  4  /* Error Correction Value bit 4 position. */
#define RTC_ERROR_5_bm  (1<<5)  /* Error Correction Value bit 5 mask. */
#define RTC_ERROR_5_bp  5  /* Error Correction Value bit 5 position. */
#define RTC_ERROR_6_bm  (1<<6)  /* Error Correction Value bit 6 mask. */
#define RTC_ERROR_6_bp  6  /* Error Correction Value bit 6 position. */
#define RTC_SIGN_bm  0x80  /* Error Correction Sign Bit bit mask. */
#define RTC_SIGN_bp  7  /* Error Correction Sign Bit bit position. */

/* RTC.CLKSEL  bit masks and bit positions */
#define RTC_CLKSEL_gm  0x03  /* Clock Select group mask. */
#define RTC_CLKSEL_gp  0  /* Clock Select group position. */
#define RTC_CLKSEL_0_bm  (1<<0)  /* Clock Select bit 0 mask. */
#define RTC_CLKSEL_0_bp  0  /* Clock Select bit 0 position. */
#define RTC_CLKSEL_1_bm  (1<<1)  /* Clock Select bit 1 mask. */
#define RTC_CLKSEL_1_bp  1  /* Clock Select bit 1 position. */

/* RTC.PITCTRLA  bit masks and bit positions */
#define RTC_PITEN_bm  0x01  /* Enable bit mask. */
#define RTC_PITEN_bp  0  /* Enable bit position. */
#define RTC_PERIOD_gm  0x78  /* Period group mask. */
#define RTC_PERIOD_gp  3  /* Period group position. */
#define RTC_PERIOD_0_bm  (1<<3)  /* Period bit 0 mask. */
#define RTC_PERIOD_0_bp  3  /* Period bit 0 position. */
#define RTC_PERIOD_1_bm  (1<<4)  /* Period bit 1 mask. */
#define RTC_PERIOD_1_bp  4  /* Period bit 1 position. */
#define RTC_PERIOD_2_bm  (1<<5)  /* Period bit 2 mask. */
#define RTC_PERIOD_2_bp  5  /* Period bit 2 position. */
#define RTC_PERIOD_3_bm  (1<<6)  /* Period bit 3 mask. */
#define RTC_PERIOD_3_bp  6  /* Period bit 3 position. */

/* RTC.PITSTATUS  bit masks and bit positions */
#define RTC_CTRLBUSY_bm  0x01  /* CTRLA Synchronization Busy Flag bit mask. */
#define RTC_CTRLBUSY_bp  0  /* CTRLA Synchronization Busy Flag bit position. */

/* RTC.PITINTCTRL  bit masks and bit positions */
#define RTC_PI_bm  0x01  /* Periodic Interrupt bit mask. */
#define RTC_PI_bp  0  /* Periodic Interrupt bit position. */

/* RTC.PITINTFLAGS  bit masks and bit positions */
/* RTC_PI  is already defined. */

/* RTC.PITDBGCTRL  bit masks and bit positions */
/* RTC_DBGRUN  is already defined. */

//==============================================================================
// Mock devices
//==============================================================================
extern RTC_t RTC;

#endif
