amykyta3/nav-brick/firmware/utils/fifo.h

/*
* Copyright (c) 2014, Alexander I. Mykyta
* All rights reserved.
*
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
* THIS SOFTWARE IS PROVIDED BY THE COPYRIGHT HOLDERS AND CONTRIBUTORS "AS IS" AND
* ANY EXPRESS OR IMPLIED WARRANTIES, INCLUDING, BUT NOT LIMITED TO, THE IMPLIED
* WARRANTIES OF MERCHANTABILITY AND FITNESS FOR A PARTICULAR PURPOSE ARE
* DISCLAIMED. IN NO EVENT SHALL THE COPYRIGHT OWNER OR CONTRIBUTORS BE LIABLE FOR
* ANY DIRECT, INDIRECT, INCIDENTAL, SPECIAL, EXEMPLARY, OR CONSEQUENTIAL DAMAGES
* (INCLUDING, BUT NOT LIMITED TO, PROCUREMENT OF SUBSTITUTE GOODS OR SERVICES;
* LOSS OF USE, DATA, OR PROFITS; OR BUSINESS INTERRUPTION) HOWEVER CAUSED AND
* ON ANY THEORY OF LIABILITY, WHETHER IN CONTRACT, STRICT LIABILITY, OR TORT
* (INCLUDING NEGLIGENCE OR OTHERWISE) ARISING IN ANY WAY OUT OF THE USE OF THIS
* SOFTWARE, EVEN IF ADVISED OF THE POSSIBILITY OF SUCH DAMAGE.
*/

/**
* \addtogroup MOD_FIFO FIFO Ring Buffer
* \brief FIFO Ring Buffer
* \author Alex Mykyta
*
* This module creates a generic First-in First-out ring buffer.
*
* \{
**/

/**
* \file
* \brief Include file for \ref MOD_FIFO
* \author Alex Mykyta
**/

#ifndef FIFO_H
#define FIFO_H

#ifdef __cplusplus
extern "C" {
#endif

#include <stdint.h>
#include <stddef.h>

//==================================================================================================
// Struct Typedefs
//==================================================================================================

// FIFO object
typedef struct {
    uint8_t *bufptr;    // pointer to the buffer array
    size_t bufsize;    // size of buffer
    size_t rdidx;    // points to next address to be read
    size_t wridx;    // points to next address to be written
#if(FIFO_LOG_MAX_USAGE == 1)
    size_t max;
#endif
} FIFO_t;

//==================================================================================================
// Function Prototypes
//==================================================================================================
/**
* \brief Initializes a new FIFO Ring Buffer
* \param [in] bufptr Pointer to the buffer to be used as storage for the FIFO
* \param [in] bufsize Size of the buffer in bytes
* \param [in] fifo Pointer to an empty #FIFO_t object
* \param [out] fifo Initialized FIFO object
* \return Nothing
**/
void fifo_init(FIFO_t *fifo, void *bufptr, size_t bufsize);

/**
* \brief Write data into the FIFO buffer
* \param [in] fifo Pointer to the #FIFO_t object
* \param [in] src Pointer to the data to be stored
* \param [in] size Number of bytes to be written to the FIFO
* \retval 0 OK
* \retval -1 Not enough space in FIFO for requested write operation
**/
int fifo_write(FIFO_t *fifo, void *src, size_t size);

/**
* \brief Write data into the FIFO buffer. Tramples over oldest unread data if necessary.
* \param [in] fifo Pointer to the #FIFO_t object
* \param [in] src Pointer to the data to be stored
* \param [in] size Number of bytes to be written to the FIFO
**/
void fifo_write_trample(FIFO_t *fifo, void *src, size_t size);

/**
* \brief Read data from the FIFO buffer
* \param [in] fifo Pointer to the #FIFO_t object
* \param [out] dst Destination of the data to be read. A \c NULL pointer discards the data.
* \param [in] size Number of bytes to be read from the FIFO
* \retval 0 OK
* \retval -1 Not enough bytes written in FIFO for requested read operation
**/
int fifo_read(FIFO_t *fifo, void *dst, size_t size);

/**
* \brief Read as much data from the FIFO buffer as possible
* \param [in] fifo Pointer to the #FIFO_t object
* \param [out] dst Destination of the data to be read. A \c NULL pointer discards the data.
* \param [in] max_size Maximum number of bytes to be read from the FIFO
* \return Number of bytes read
**/
size_t fifo_read_max(FIFO_t *fifo, void *dst, size_t max_size);

/**
* \brief Read data from the FIFO buffer without advancing the read pointer
* \param [in] fifo Pointer to the #FIFO_t object
* \param [out] dst Destination of the data to be read.
* \param [in] size Number of bytes to be read from the FIFO
* \retval 0 OK
* \retval -1 Not enough bytes written in FIFO for requested read operation
**/
int fifo_peek(FIFO_t *fifo, void *dst, size_t size);

/**
* \brief Empties the FIFO
* \param [in] fifo Pointer to the #FIFO_t object
* \return Nothing
**/
void fifo_clear(FIFO_t *fifo);

/**
* \brief Get the number of bytes available for read in the FIFO
* \param [in] fifo Pointer to the #FIFO_t object
* \return Number of bytes
**/
size_t fifo_rdcount(FIFO_t *fifo); // Returns the number of bytes currently stored in the FIFO

/**
* \brief Get the number of bytes that can be written to the FIFO
* \param [in] fifo Pointer to the #FIFO_t object
* \return Number of bytes
**/
size_t fifo_wrcount(FIFO_t *fifo); // Returns the number of bytes free in the FIFO


#ifdef __cplusplus
}
#endif

#endif
///\}
