amykyta3/nav-brick/(commit log)

2023-07-10 PCB As fabricated
    [GPS.kicad_sch, USB.kicad_sch, display-segment.kicad_sch, display.kicad_sch, navbrick.kicad_pcb, navbrick.kicad_sch, sensors.kicad_sch]
2023-08-08 Initial firmware
    [BOM.ods, GPS.kicad_sch, USB.kicad_sch, display-segment.kicad_sch, display.kicad_sch, navbrick.kicad_pcb, navbrick.kicad_sch, sensors.kicad_sch]
2023-08-09 Add hardware ECO notes
    [navbrick.kicad_pcb]
2023-08-11 Fixup pressure sensor firmware
    [cli_commands.c, cli_commands.h, main.c, ms5611_pressure.c]
2023-08-14 GPS is alive!
    [navbrick.kicad_pcb]
2023-09-03 Rev B hardware update
    [GPS.kicad_sch, USB.kicad_sch, display.kicad_sch, navbrick.kicad_pcb, navbrick.kicad_sch]
2023-09-06 Add assy list
    [assembly-list.ods]
2023-09-09 Add pdf
    [display.kicad_sch, navbrick.kicad_pcb, navbrick.kicad_sch]
2023-11-14 Fix pressure compensation casting bug
    [altitude.c, cli_commands.c, cli_commands.h, gui.c, ms5611_pressure.c, sensors.c, slate.h]
2023-11-14 Debug gps frame errors
    [cli_commands.c, gui.c, slate.h, ubx.c]
2023-11-19 Fix trailing dot display bug
    [gui.c, segment_codes.c]
2026-07-31 Convert to PartDB
    [GPS.kicad_sch, USB.kicad_sch, display-segment.kicad_sch, display.kicad_sch, navbrick.kicad_sch, sensors.kicad_sch]
2026-08-05 minor fixups
    [navbrick.kicad_pcb, navbrick.kicad_sch]
2026-08-09 Add more detailed trim to altitude to avoid bracketing effect
    [altitude.c]
2026-08-09 Speed up UART
2026-08-09 Swap button functions. More intuitive this way
    [main.c]
